WPI-AIM/AutoBVM/README.md

# AutoBVM
WPI AutoBVM Ventilator Project 
Developed as part of the Pandemic Engineering Program 

Designs for the system developed are avaialble here (mechanical, electrical, and software), and additional ongiong contributions and updates will appear here. All designs are available open source. We request that users inform us that are using them by emailing: info@autobvm.org. Please also contact us if you would like to contribute, which we highly encourage.

Please check in frequently as we are continuously making updates and will be curating feedback from others contributors here....

Please see http://autobvm.org for project information for the origins of this effort.
