WPI-AIM/AutoBVM/Electronics/README.md

The electronics hardware designs are in here.

Please see "Main Board Rev 2" for the latest and released board designs. This is what was provided to the goups that received pre-made hardware.

The posted designs include a pdf as a quick reference, manufacturing files to replicate, and Altium Designer files for viewing/modifying.
If you do not have Altium Designer, there is a free viewer avaialble online: https://www.altium.com/viewer/
