WPI-AIM/AutoBVM/Documentation/Docs - Breathing Circuit.pdf

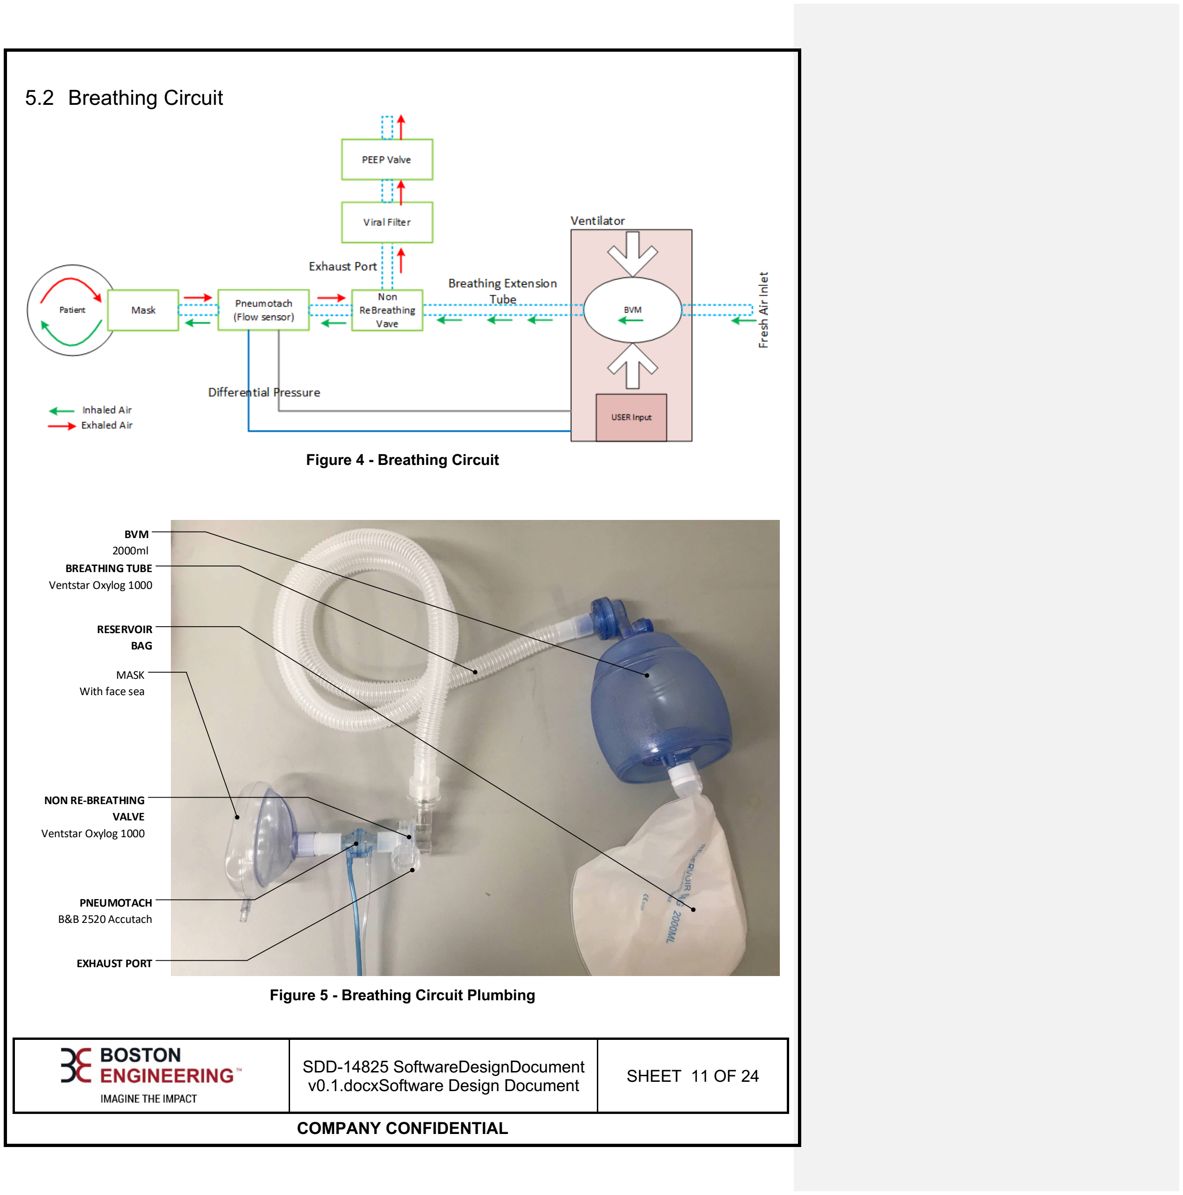
[picture p3: figure]
SDD-14825 SoftwareDesignDocument; COMPANY CONFIDENTIAL; 5.2 Breathing Circuit; Figure 4 - Breathing Circuit; Figure 5 - Breathing Circuit Plumbing; MASK With face sea; PNEUMOTACH B&B 2520 Accutach; EXHAUST PORT; NON RE-BREATHING VALVE Ventstar Oxylog 1000; BREATHING TUBE Ventstar Oxylog 1000; BVM 2000ml; RESERVOIR BAG

### v0.1.docxSoftware Design Document SHEET 11 OF 24
