WPI-AIM/AutoBVM/Electronics/LCD Board Rev 1/4391G01_BOM_6-2-21.xls

Comment | Description | Designator | Quantity | Manufacturer Part Number | Manufacturer | Supplier | Supplier Part Number
9774100151 | RND STNDFF M2.5X0.45 STEEL 10MM | MH3, MH4 | 2 | 9774100151R | Wurth Electronics | Digi-Key | 732-7117-1-ND
686106148922 | CONN 1MM HORZ BOTTOM SMD 6POS | J3 | 1 | 686106148922 | Wurth Electronics | Digi-Key | 732-6017-1-ND
N2526-6V0C-RB-WE | CONN HEADER SMD 26POS 2.54MM | J1 | 1 | N2526-6V0C-RB-WE | 3M | Digi-Key | MSH26KCT-ND
SSM-115-S-SV | CONN RCPT 15POS 0.1 GOLD SMD | J2 | 1 | SSM-115-S-SV | Samtec | Samtec | https://www.samtec.com/products/ssm-115-s-sv
