WPI-AIM/AutoBVM/Electronics/Main Board Rev 2/4381G01_Rev_2_BOM_7-7-21.xls

Comment | Description | Designator | Quantity | Manufacturer Part Number | Manufacturer | Supplier | Supplier Part Number | Rev 1 Qty | Difference
N2526-6002-RB | CONN HEADER VERT 26POS 2.54MM | J9 | 1 | N2526-6002RB | 3M | Digi-Key | MHC26K-ND | 1 | 0
CEP-2242 | Audio Indicators & Alerts Buzzers | BUZ1 | 1 | CEP-2242 | CUI | Digi-Key | 102-1115-ND | 1 | 0
GF-123-0054 | SWITCH SLIDE SPST 8.5A 125V | P13 | 1 | GF-123-0054 | CW Industries | Digi-Key | CWI333-ND | 1 | 0
78B05ST | SWITCH SLIDE DIP SPST 150MA 30V | SW1 | 1 | 78B05ST | Grayhill | Digi-Key | GH7186-ND | 1 | 0
M20-9980346 | CONN HEADER VERT 6POS 2.54MM | JP1, JP2, JP3, JP4, JP5, JP6 | 6 | M20-9980346 | Harwin | Digi-Key | 952-2121-ND | 6 | 0
SSCDRRN002NDAA5 | SENSOR PRES 0.07PSI DIFF 5V DIP | U6 | 1 | SSCDRRN002NDAA5 | Honeywell | Mouser | 785-SSCDRRN002NDAA5 | 0 | 1 | *BEC to Provide (Part Changed from SSCDRRN001PDAA5)
SSCDRRN001PGAA5 | SENSOR PRES 1PSI GAUG 5V DIP | U8, U9 | 2 | SSCDRRN001PGAA5 | Honeywell Sensing & Control | Digi-Key | 480-5972-ND | 2 | 0 | *BEC Already Provided and U9 DNP
BSC190N12NS3GATMA1 | MOSFET N-CH 120V 8.6A/44A TDSON | Q2 | 1 | BSC190N12NS3G | Infineon | Digi-Key | BSC190N12NS3GATMA1CT-ND | 1 | 0
3587TR | FUSE HOLDER BLADE 20A PCB | P9, P12 | 2 | 3587TR | Keystone Electronics | Digi-Key | 36-3587CT-ND | 2 | 0
5002 | PC TEST POINT MINIATURE WHITE | TP1, TP2, TP3, TP4, TP20, TP21, TP22, TP23, TP24, TP25, TP26, TP27, TP28, TP29, TP30, TP31, TP32, TP33, TP34, TP35, TP36, TP37, TP38 | 23 | 5002 | Keystone Electronics | Digi-Key | 36-5002-ND | 17 | 6
5001 | PC TEST POINT MINIATURE BLACK | TP10, TP11, TP12, TP13, TP17, TP19 | 6 | 5001 | Keystone Electronics | Digi-Key | 36-5001-ND | 6 | 0
5000 | PC TEST POINT MINIATURE RED | TP5, TP6, TP7, TP8, TP9, TP14, TP15, TP16, TP18 | 9 | 5000 | Keystone Electronics | Digi-Key | 36-5000-ND | 9 | 0
LTC4357IMS8 | IC OR CTRLR N+1 8MSOP | U2 | 1 | LTC4357IMS8 | Linear Technology | Digi-Key | LTC4357IMS8#PBF-ND | 1 | 0
SMAJ70CA | TVS DIODE 70VWM 113VC SMA | D1 | 1 | SMAJ70CA | Littlefuse Inc | Digi-Key | SMAJ70CALFCT-ND | 1 | 0
MAX14890EATJ+T | IC RECEIVER 0/4 32TQFN | U10 | 1 | MAX14890EATJ+T | Maxim | Digi-Key | MAX14890EATJ+TCT-ND | 1 | 0
24AA256T-I/SN | IC EEPROM 256KBIT I2C 8SOIC | U1 | 1 | 24AA256T-I/SN | Microchip | Mouser | 579-24AA256-I/SN | 1 | 0
43045-0828 | CONN HEADER VERT 8POS 3MM | P6 | 1 | 430450828 | Molex | Digi-Key | WM10693-ND | 1 | 0
BLM18RK102SN1D | FERRITE BEAD 1 KOHM 0603 1LN | FER1, FER2, FER3 | 3 | BLM18RK102SN1D | Murata | Digi-Key | 490-5228-1-ND | 2 | 1
NUD3124DMT1G | IC PWR DRIVER N-CHANNEL 1:1 SC74 | Q1, Q3 | 2 | NUD3124DMT1G | ON Semiconductor | Digi-Key | NUD3124DMT1GOSCT-ND | 2 | 0
MMBD1205 | DIODE ARRAY GP 100V 200MA SOT23 | D2 | 1 |  | On Semiconductor | Digi-Key | MMBD1205CT-ND | 1 | 0
1881639 | TERM BLOCK HDR 10POS VERT 2.5MM | P8, P10, P15 | 3 | 1881639 | Phoenix Contact | Digi-Key | 277-1460-ND | 3 | 0
1803442 | TERM BLOCK HDR 4POS VERT 3.81MM | P5, P16, P17, P18, P19 | 5 | 1803442 | Phoenix Contact | Digi-Key | 277-1223-ND | 5 | 0
1803439 | TERM BLOCK HDR 3POS VERT 3.81MM | P1, P2, P3, P4 | 4 | 1803439 | Phoenix Contact | Digi-Key | 277-1222-ND | 4 | 0
1755765 | TERM BLOCK HDR 5POS VERT 5.08MM | P14 | 1 | 1755765 | Phoenix Contact | Digi-Key | 277-1153-ND | 1 | 0
1755736 | TERM BLOCK HDR 2POS VERT 5.08MM | P7, P11, P20 | 3 | 1755736 | Phoenix Contact | Digi-Key | 277-1150-ND | 3 | 0
RP30-2412SEW | Single, Isolated Module DC DC Converter Output 12V - - 2.5A 10V - 40V Input | U3 | 1 | RP30-2412SEW | Recom | Digi-Key | 945-2750-5-ND | 1 | 0
1000pF | CAP CER 1000PF 2KV X7R 1206 | C6, C12 | 2 | CL31B102KJHNNNE | Samsung | Digi-Key | 1276-3073-1-ND | 2 | 0
PC81710NIP1B |  | OP1 | 1 | PC81710NIP1B | Sharp | Mouser | 852-PC81710NIP1B | 1 | 0
LD39150DT33-R | IC REG LINEAR 3.3V 1.5A DPAK | U5 | 1 | LD39150DT33-R | STMicroelectronics | Digi-Key | 497-6448-1-ND | 1 | 0
PPTC101LFBN-RC | CONN HDR 10POS 0.1 TIN PCB | J2 | 1 | PPTC101LFBN-RC | Sullins | Digi-Key | S7008-ND | 1 | 0
PPTC081LFBN-RC | CONN HDR 8POS 0.1 TIN PCB | J1, J3, J4, J5, J7 | 5 | PPTC081LFBN-RC | Sullins | Digi-Key | S7006-ND | 5 | 0
PPTC061LFBN-RC | CONN HDR 6POS 0.1 TIN PCB | J10, J11 | 2 | PPTC061LFBN-RC | Sullins | Digi-Key | S7004-ND | 2 | 0
PPPC182LFBN-RC | CONN HDR 36POS 0.1 GOLD PCB | J8 | 1 | PPPC182LFBN-RC | Sullins | Digi-Key | S7121-ND | 1 | 0
PPPC032LFBN-RC | CONN HDR 6POS 0.1 GOLD PCB | J6 | 1 | PPPC032LFBN-RC | Sullins | Digi-Key | S7106-ND | 1 | 0
196K | RES SMD 196K OHM 0.1% 1/8W 0805 | R80, R84, R88 | 3 | RG2012P-1963-B-T5 | Susumu | Digi-Key | RG20P196KBCT-ND | 3 | 0
100k | RES SMD 100K OHM 0.1% 1/8W 0805 | R77, R81, R85 | 3 | RG2012P-104-B-T5 | Susumu | Digi-Key | RG20P100KBCT-ND | 3 | 0
TSSA3U45 R3G | DIODE SCHOTTKY 45V 3A DO214AC | D3 | 1 | TSSA3U45 R3G | Taiwan Semiconductor | Digi-Key | TSSA3U45R3GCT-ND | 1 | 0
TS2596CM550RN | IC REG BUCK 5V 3A TO263-5 | U4 | 1 | TS2596CM550RN | Taiwan Semiconductor | Digi-Key | TS2596CM550RNGCT-ND | 1 | 0
1.0uF | CAP CER 1UF 50V X5R 0603 | C18, C20 | 2 | UMK107BJ105KA-T | Taiyo Yuden | Digi-Key | 587-2400-1-ND | 2 | 0
10uF | CAP CER 10UF 100V X7S 2220 | C17, C33 | 2 | C5750X7S2A106K230KB | TDK | Digi-Key | 445-13408-1-ND | 1 | 1
VCF4-1000 | RELAY SOCKET 5 POS THROUGH HOLE | K1, K2 | 2 | VCF4-1000 | TE Connectivity | Newark | 17M3156 | 2 | 0
SN74LVC1G125DBVT | IC BUF NON-INVERT 5.5V SOT23-5 | U12, U13 | 2 | SN74LVC1G125DBVT | Texas Instruments | Digi-Key | 296-26595-1-ND | 0 | 2 | *New Part on Rev 2
OPA4343UA | IC OPAMP GP 4 CIRCUIT 14SOIC | U7 | 1 | OPA4343UA | Texas Instruments | Digi-Key | 296-41593-5-ND | 1 | 0
CDCLVC1103PW | IC CLK BUFFER 1:3 250MHZ 8TSSOP | U11 | 1 | CDCLVC1103PW | Texas Instruments | Digi-Key | 296-33169-5-ND | 0 | 1 | *New Part on Rev 2
6.8µF | CAP CER 6.8UF 100V X7R 2220 | C8, C9 | 2 | KTS101B685K55F0T00 | United Chemi-Con | Digi-Key | 565-3678-1-ND | 2 | 0
470µF | CAP ALUM 470UF 20% 25V RADIAL | C7, C13, C15 | 3 | 860020474014 | Wurth Electronics | Digi-Key | 732-8831-1-ND | 3 | 0
450µH @ 100 kHz | CMC 450UH 6.5A 2LN TH | L1 | 1 | 7448227005 | Wurth Electronics | Digi-Key | 732-3883-ND | 1 | 0
47µH | FIXED IND 47UH 3.8A 60 MOHM SMD | L2, L3 | 2 | 7447709470 | Wurth Electronics | Newark | 08P2777 | 1 | 1
0 | RES SMD 0 OHM JUMPER 1/10W 0603 | R7, R8, R10, R14, R16, R17, R18, R19, R20, R21, R23, R25, R27, R29, R34, R38, R44, R47, R48, R49, R50, R51, R52, R53, R54, R56, R58, R59, R63, R64, R69, R71, R73, R74, R79, R83, R87, R89, R90, R92, R93, R98, R100, R101, R102, R103, R105, R106, R107, R109, R111, R113, R115, R117, R131, R132, R133, R134, R135, R136, R137, R138, R139, R140, R153, R154, R155, R156, R157, R158, R159, R160, R162, R163 | 74 | RC0603JR-070RL | Yageo | Digi-Key | 311-0.0GRCT-ND | 74 | 0
422 | RES SMD 422 OHM 1% 1/10W 0603 | R55 | 1 | RC0603FR-07422RL | Yageo | Digi-Key | 311-422HRCT-ND | 1 | 0
10 | RES SMD 10 OHM 1% 1/10W 0603 | R1, R2, R3, R4, R12, R13, R15, R22, R70, R78, R82, R86, R91 | 13 | RC0603FR-0710RL | Yageo | Digi-Key | 311-10.0HRCT-ND | 9 | 4
10k | RES SMD 10K OHM 1% 1/10W 0603 | R5, R6, R11, R26, R28, R30, R31, R32, R41, R42, R43, R46, R66, R67, R72, R75, R76, R94, R95, R96, R97, R120, R124, R125, R128, R144, R145, R146, R147, R148, R164 | 31 | RC0603FR-0710KL | Yageo | Digi-Key | 311-10.0KHRCT-ND | 24 | 7
0.1µF | Cap Ceramic 0.1uF 100V X7R 10% Pad SMD 0603 125°C T/R | C1, C2, C3, C4, C5, C14, C16, C21, C22, C23, C24, C25, C26, C27, C28, C29, C30, C31, C34, C35 | 20 | CC0603KRX7R0BB104 | Yageo | Digi-Key | 311-1523-1-ND | 17 | 3
2.2µF | CAP CER 2.2UF 25V X5R 0603 | C10, C11, C19, C32 | 4 | CC0603KRX5R8BB225 | Yageo | Digi-Key | 311-1786-1-ND | 3 | 1
R0603_DNP | R0603 Do Not Populate | R9, R24, R33, R35, R36, R37, R39, R40, R45, R57, R60, R61, R62, R65, R68, R99, R104, R108, R110, R112, R114, R116, R118, R119, R121, R122, R123, R126, R127, R129, R130, R141, R142, R143, R149, R150, R151, R152, R161, R165 | 40 | N/A | N/A | N/A | N/A | 46 | -6
