WPI-AIM/AutoBVM/Documentation/calibration transforms/test_setup.pdf

# Fluke Test Setup

# June 8th, 2021

## Relationship between Flow and Diff. Pressure Flow range: 0 to 180Liters/min Resolution: 40ml/min

## 25250 (https://bandb-medical.com/wp-content/uploads/2020/05/25250C2-Accutach.pdf)

VT650 (https://www.flukebiomedical.com/products/biomedical-test-equipment/gas-flow-analyzers-ventilator-testers/vt650-gas-flow-analyzer-ventilator-tester)

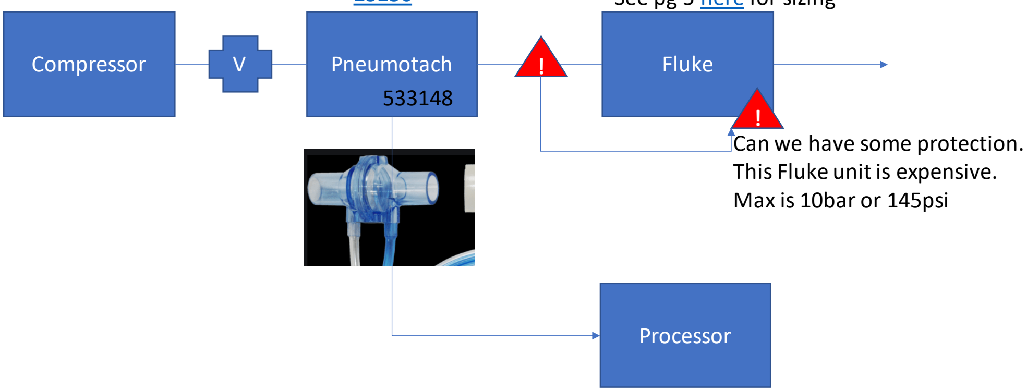
[picture p5: figure]
Compressor; Pneumotach; Fluke; Processor; ! Can we have some protection. This Fluke unit is expensive. Max is 10bar or 145psi

See pg 5 here (https://www.flukebiomedical.com/sites/default/files/6009788c-en-vt650-ds.pdf) for sizing

## Initial Proposed Set-Up

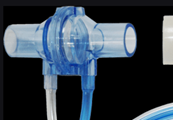
[picture p6: figure]
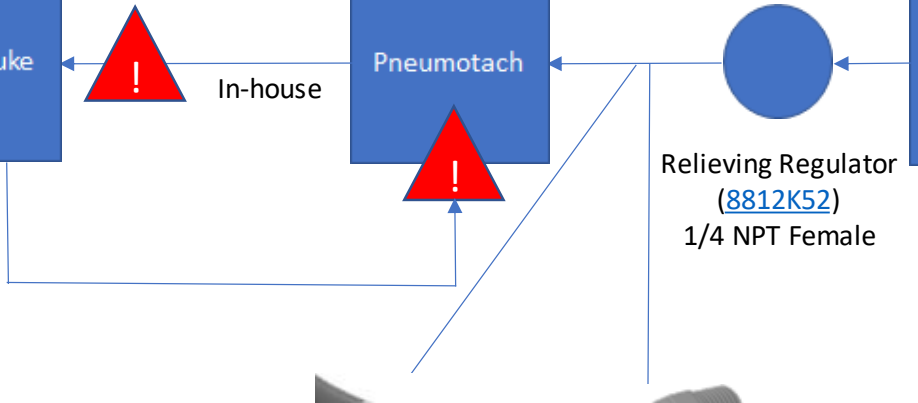
[picture p7: figure]
Relieving Regulator (8812K52) 1/4 NPT Female; In-house

Adapter
(5372K747) (https://www.mcmaster.com/5372K747/)
1/4 NPT to 10 mm

Tygon PVC Tubing
(3902N306) (https://www.mcmaster.com/3902N306/)
10 mm ID, 17 mm OD

Flow: 0 to 180 L/min (~ 6 cfm) Accuracy: +/- 25 mL or +/- 10% Connectors: 22 mm OD tubing

25250 (https://bandb-medical.com/wp-content/uploads/2020/05/25250C2-Accutach.pdf) Pneumotach Flow Sensor

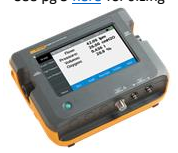
[picture p8: figure]

Flow: 0 to 300 SLPM
Accuracy: 1.7% or 0.04 SLPM Connectors: 15mm ID/ 22mm OD adapter

VT650 (https://www.flukebiomedical.com/products/biomedical-test-equipment/gas-flow-analyzers-ventilator-testers/vt650-gas-flow-analyzer-ventilator-tester) Gas Flow Analyzer
See pg 5 here (https://www.flukebiomedical.com/sites/default/files/6009788c-en-vt650-ds.pdf) for sizing

Tygon PVC Tubing
(3902N306) (https://www.mcmaster.com/3902N306/)
10 mm ID, 17 mm OD

Pressure Release Valve
(5 psi, 4772K2) (https://www.mcmaster.com/4772K2-4772K201/)
1/8 NPT Male

Adapter
(5372K747) (https://www.mcmaster.com/5372K747/)
1/4 NPT to 10 mm

Relationship between Flow and Diff. Pressure
Operating Parameters: 1 psi max, up to 180 L/min (~6 cfm)

Note: Tygon tubing to be attached to Fluke outlet and Pneumotach inlet via moisture-seal heat shrink (74965K57) (https://www.mcmaster.com/74965K57/)

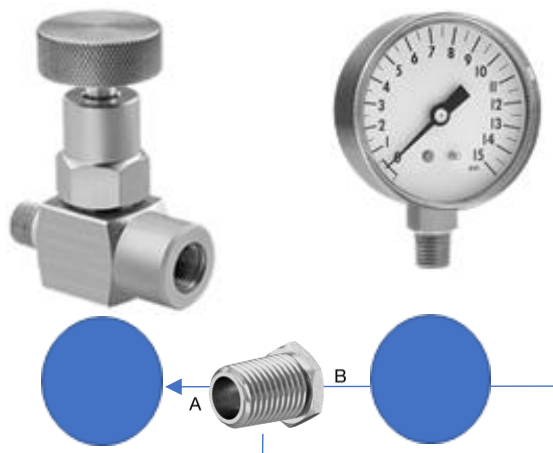
[picture p9: figure]

Gauge
(3846K411) (https://www.mcmaster.com/3846K411-3846K412/)
1/8 NPT Pipe Size
OD: 2.0625”

Needle Valve
(7833K76) (https://www.mcmaster.com/7833K76/)
1/4 NPT Thread

Al Manifold
(5975K31) (https://www.mcmaster.com/5975K31/)

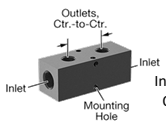
[picture p10: figure]

Inlets: 1/4 NPT Threaded
Outlets: 1/8 NPT Male

## Final Proposed Set-Up

Reducer
(4464K261) (https://www.mcmaster.com/4464K261/)
1/4 to 1/8 NPT

## Variable Definition: ρ: density of air

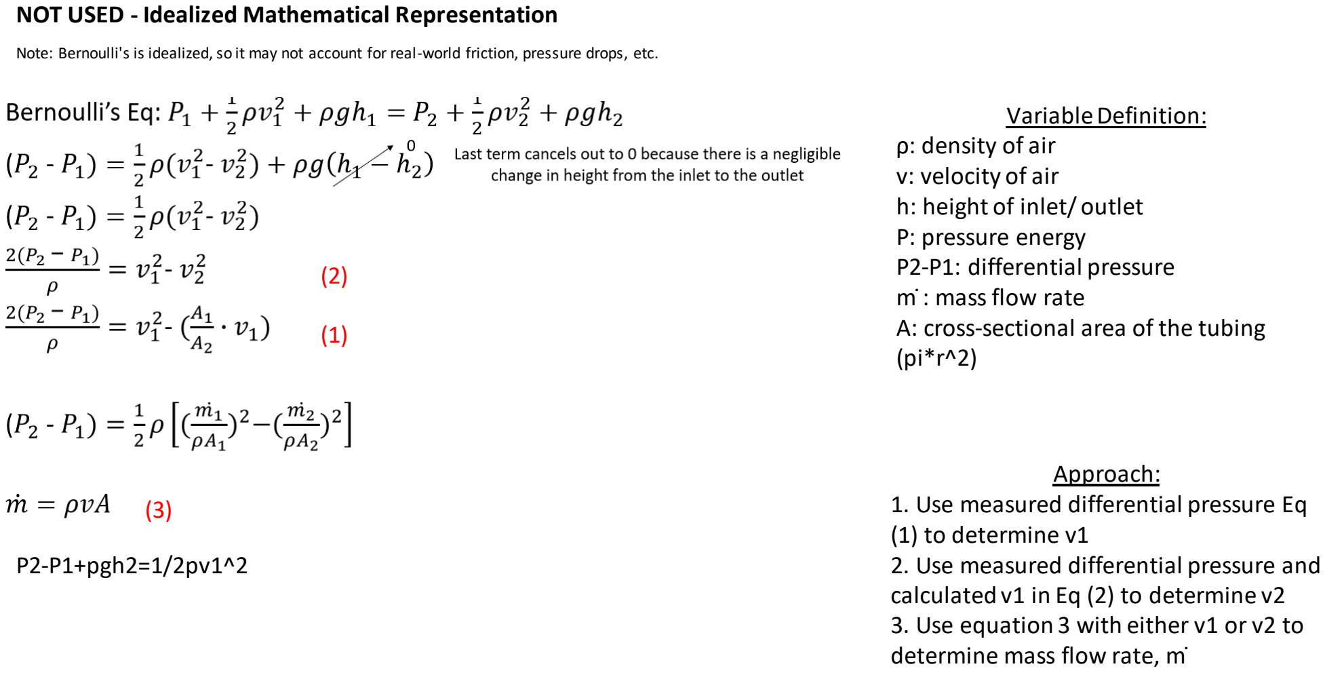
[picture p11: page 4]

## Approach: 1. Use measured differential pressure Eq (1) to determine v1 2. Use measured differential pressure and calculated v1 in Eq (2) to determine v2 3. Use equation 3 with either v1 or v2 to determine mass flow rate, m ̇

## v: velocity of air h: height of inlet/ outlet P: pressure energy P2-P1: differential pressure m ̇: mass flow rate A: cross-sectional area of the tubing (pi*r^2)

## NOT USED - Idealized Mathematical Representation

Note: Bernoulli's is idealized, so it may not account for real-world friction, pressure drops, etc.

(1)

(2)

(3)

## P2-P1+pgh2=1/2pv1^2
