WPI-AIM/AutoBVM/Documentation/calibration transforms/deg vs volume.xlsx

 |  |  |  |  |  |  |  |  | PADDLE POSITION(deg) vs BAG VOLUME(l)
Test Setup
 | Ambu bag model: AMBU SPUR II
 | Ventilator->Ambu Bag->Pneumotach(Unused, but in loop)->Fluke->Lung
 | Bag exhaust port closed.
 | Run following steps for No Lung, C=50, C=20
Step 1 | Take 5 sets of readings @20 deg/sec and 100 deg/sec of the paddle
Step 2 | Average the readings
Step 3 | Curve fit the average
Step 4 | Curve fit for inverse Volume vs Degree
 |  |  |  |  |  |  |  |  |  |  |  |  |  |  |  | Speed (20 deg/sec) |  |  |  |  |  |  | Speed (100 deg/sec) |  |  |  |  |  |  | Speed (20 deg/sec) |  |  |  |  |  |  | Speed (100 deg/sec)
 | Speed (20 deg/sec) |  |  |  |  |  |  |  | Speed (100 deg/sec) |  |  |  |  |  |  | With Lung, C = 50 (mL/cmH20) |  |  |  |  |  |  | With Lung, C = 50 (mL/cmH20) |  |  |  |  |  |  | With Lung, C = 20 (mL/cmH20) |  |  |  |  |  |  | With Lung, C = 20 (mL/cmH20)
 | No Lung |  |  |  |  |  |  |  | No Lung |  |  |  |  |  |  |  | test 1 | test 2 | test 3 | test 4 | test 5 | Average |  | test 1 | test 2 | test 3 | test 4 | test 5 | Average |  | test 1 | test 2 | test 3 | test 4 | test 5 | Average |  | test 1 | test 2 | test 3 | test 4 | test 5 | Average
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
