WPI-AIM/AutoBVM/Documentation/calibration transforms/diff_to_flow.xlsx

Sheet: 0.04 mbar steps
 |  |  |  |  |  |  | DIFFERENTIAL PRESSURE(mbar)vs FLOW(lpm)
Test Setup
Inspiration | Compressor->Regulator->Pneumotach(Low pressure ports of Fluke)->Fluke->Needle Valve
Expiration | Compressor->Regulator->Fluke->Pneumotach(Low pressure ports of Fluke)->Needle Valve
 | Change Diff Pressure(mbar) in increments of 0.04 and note Flow(lpm)
Step 1 | Take 3 sets of readings
Step 2 | Average the readings
Step 3 | Curve fit the readings
 | Repeat for Expiration
 |  | STEP 1 - Take 3 sets of readings |  |  |  | STEP 2 - Average the readings |  |  |  |  |  |  |  |  |  |  |  |  | STEP 3 - Curve fit the readings
Inflow(INSPIRATION) |  |  |  |  |  |  |  |  |  |  |  |  | Average observation
Test 1 (inflow, 0.04 mbar steps) |  | Test 2 (inflow, 0.04 mbar steps) |  | Test 3(inflow, 0.04 mbar steps) |  | Average Inflow
DP (mbar) | Flow (lpm) | DP (mbar) | Flow (lpm) | DP (mbar) | Flow (lpm) | DP (mbar) | Flow (lpm) | Average Difference | Average % Difference | DP (mbar) x | Flow (lpm) y | y from curve fit | Difference | % Difference | Average Difference | Average % Difference | Result of 4 mbar step Tests
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
