WPI-AIM/AutoBVM/Electronics/LCD Board Rev 1/PCB - Display Interface.pdf

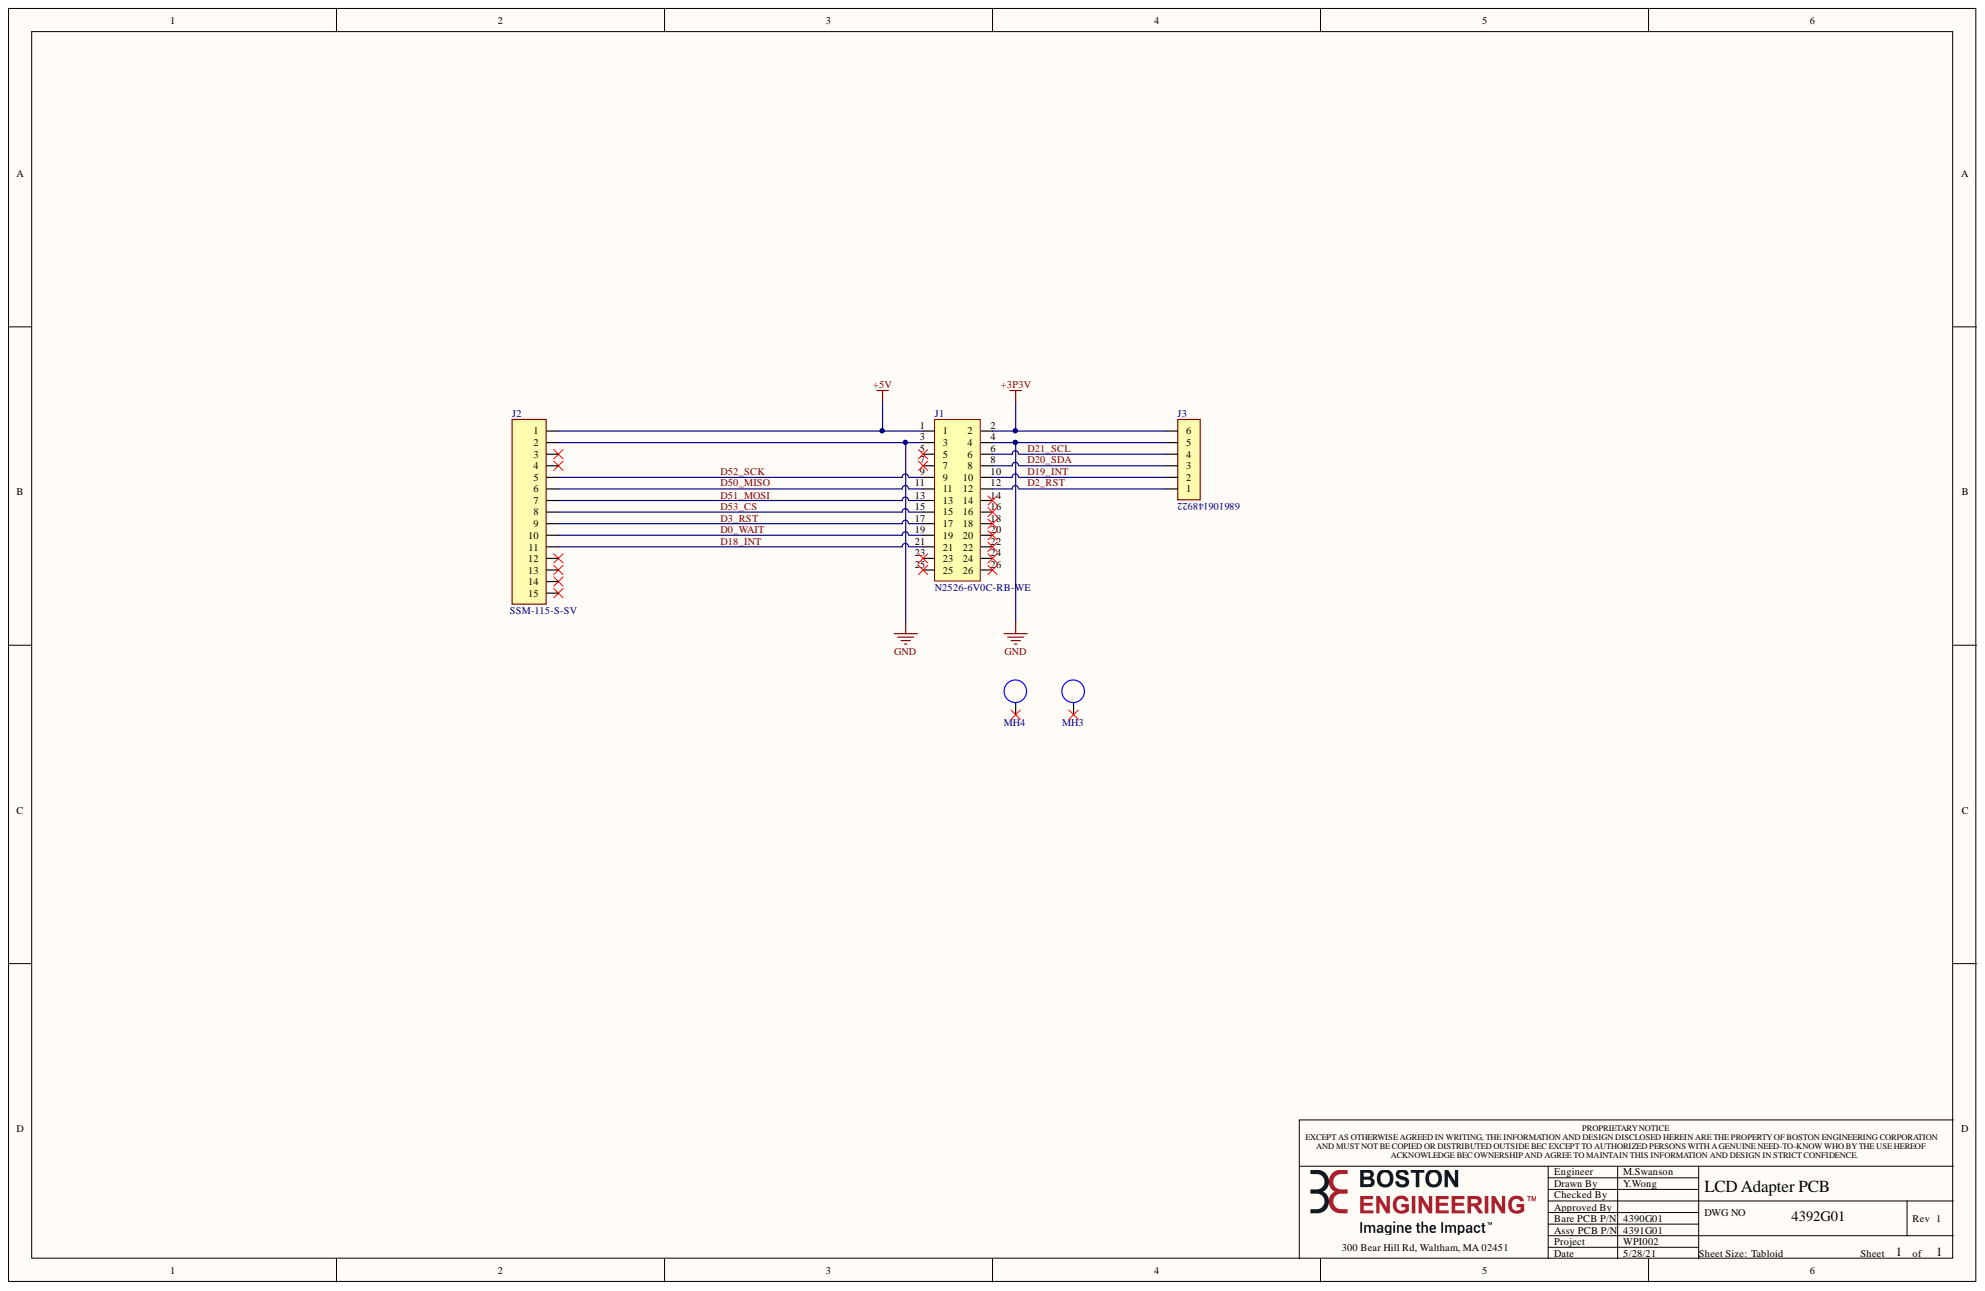
[picture p12: page 1]

3 0 0 B e a r H i l l R d , Wa l t h a m , MA 0 2 4 5 1 | E n g i n e e r | M. S w a n s o n | LCD Adapte r P C B

D r a w n B y | Y. Wo n g
C h e c k e d B y
A p p r o v e d B y | | DWG N O 4392G01 | R e v 1
B a r e P C B P / N | 4 3 9 0 G 0 1
A s s y P C B P / N | 4 3 9 1 G 0 1
P r oj e c t | WP I 0 0 2 | 1 1 S h e e t S i z e : Ta b l o i d S h e e t o f
D a t e | 5 / 2 8 / 2 1

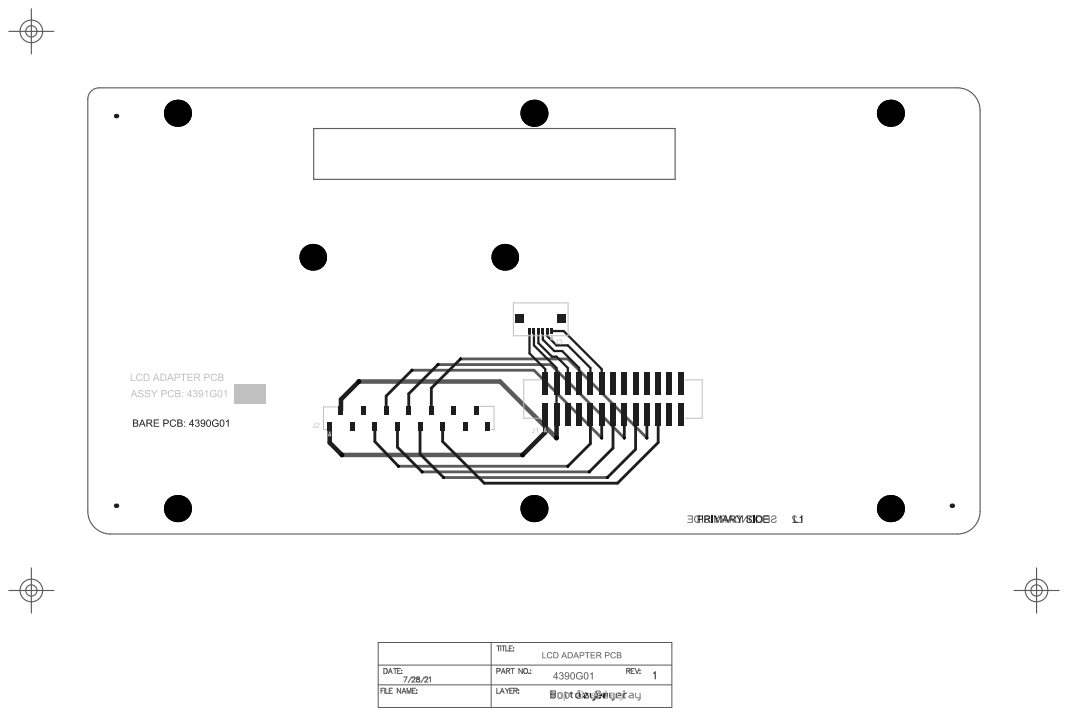
[picture p13: page 2]

Comment | Description | Designator | Footprint | LibRef | Quantity
N2526-6V0C-RB-WE | CONN HEADER SMD 2J1 | | 3M\N2526-6V0C-RB-WN2526-6V0C-RB-WE | | 1
SSM-115-S-SV | CONN RCPT 15POS 0.J2 | | SSM-115-S-SV | SSM-115-S-SV | 1
686106148922 | CONN 1MM HORZ BOTJ3 | | 686106148922 | 686106148922 | 1
9774100151 | RND STNDFF M2.5X0.MH3, MH 4 | | 9774100151 | 9774100151 | 2
