WPI-AIM/AutoBVM/Updated Firmware/source/src/controls/control.cpp

#include "control.h"
#include <display/main_display.h>
#include <utilities/util.h>
#include "../config/uvent_conf.h"
#include "actuators/actuator.h"
#include "eeprom/storage.h"
#include "sensors/pressure_sensor.h"
#include "waveform.h"
#include "alarm/alarm.h"
#include <AccelStepper.h>
#include <DueTimer.h>
#include <ams_as5048b.h>
#include <display/screens/screen.h>
#include <display/layouts/layouts.h>

#include "pcvmachine.h"
#include "pressurePID.h"

// PID Controller Instance
// PressurePID pid;

// Instance to control the paddle

// const double Kp = 0.0011;       // VALUES OBTAINED FROM A RESEARCH PAPER
// const double Ki = 0.012;
// const double Kd = 0.000015;

// const double Kp = 1.0;       // TEST VALUES
// const double Ki = 0.0;
// const double Kd = 0.0;

// float prevError = 0;
// float prevIntegral = 0;
// float bias = 0;

// // Used for timing purposes
// bool firstPID = true;
// float timeSincePID = 0;

// float target = 15.0;

// bool startPID = false;

Actuator actuator;

// Storage instance
Storage storage;

// Gauge Pressure Sensor instance
PressureSensor gauge_sensor = {PRESSURE_GAUGE_PIN};

// Differential Pressure Sensor instance
PressureSensor diff_sensor = {PRESSURE_DIFF_PIN};
// Waveform instance
Waveform waveform;

uint32_t cycle_count = 0;

// Alarms
AlarmManager alarm_manager{SPEAKER_PIN, &cycle_count};

/* State machine instance. Takes in a pointer to actuator
 * as there are actuator commands within the state machine.
 */
Machine machine(States::ST_STARTUP, &actuator, &waveform, &gauge_sensor, &alarm_manager, &cycle_count);
PCVMachine pcvMachine(States::ST_STARTUP, &actuator, &waveform, &gauge_sensor, &alarm_manager, &cycle_count);


// Bool to keep track of the alert box
static bool alert_box_already_visible = false;

void loop_test_readout(lv_timer_t* timer)
{

    static bool timer_delay_complete = false;

    // Internal timers, components might have different refresh times
    static uint32_t last_readout_refresh = 0;

    // Don't poll the sensors before we're sure everything's had a chance to init
    if (!timer_delay_complete && (millis() >= SENSOR_POLL_STARTUP_DELAY)) {
        timer_delay_complete = true;

        // Set some dummy alarms
        cycle_count++;

        alarm_manager.badPlateau(true);
        alarm_manager.lowPressure(true);
        alarm_manager.noTidalPres(true);
        alarm_manager.update();
    }
    if (!timer_delay_complete) {
        LV_LOG_TRACE("Timer is not ready yet, returning (%d)", millis());
        return;
    }

    // If verbose data polling is off, polling / updates won't be done if the state machine is off
    // If in debug screen mode, it won't be done if we're in startup state either
#if VERBOSE_DATA_POLLING == 0
    States cur_state = control_get_state();
    if (cur_state == States::ST_OFF || (!ENABLE_CONTROL && cur_state == States::ST_STARTUP)) {
        return;
    }
#endif

    // Main screen, passed through via user data in main.cpp
    auto* screen = static_cast<MainScreen*>(timer->user_data);

    // Check for errors
    handle_alerts();

    // Poll gauge sensor, add point to graph and update readout obj.
    // Will not refresh until explicitly told
    static double cur_pressure = -2;
    screen->get_chart(CHART_IDX_PRESSURE)->add_data_point(cur_pressure);           // JOSH PRESSURE
    set_readout(AdjValueType::CUR_PRESSURE, cur_pressure);
    screen->get_chart(CHART_IDX_FLOW)->add_data_point(cur_pressure);
    set_readout(AdjValueType::PLAT_PRESSURE, cur_pressure);
    cur_pressure += 1;
    cur_pressure += random(100) / 100.0;
    if (cur_pressure > 40) {
        cur_pressure -= 42;
    }

    // Poll vT sensor, add point to graph and update readout obj.
    // Will not refresh until explicitly told
    static int16_t test2 = 0;
    double cur_tidal_volume = test2;
    set_readout(AdjValueType::TIDAL_VOLUME, cur_tidal_volume);
    test2 += 50;
    if (test2 > 1000) {
        test2 -= 1002;
    }

    set_readout(RESPIRATION_RATE, 30);

    set_readout(PEEP, 30);
    set_readout(PIP, 30);

    // Check to see if it's time to refresh the readout boxes
    if (has_time_elapsed(&last_readout_refresh, READOUT_REFRESH_INTERVAL)) {
        // Refresh all of the readout labels
        for (auto& value : adjustable_values) {
            if (!value.is_dirty()) {
                continue;
            }
            value.refresh_readout();
            value.clear_dirty();
        }
    }

    screen->try_refresh_charts();
}

void loop_update_readouts(lv_timer_t* timer)
{
    static bool timer_delay_complete = false;

    // Internal timers, components might have different refresh times
    static uint32_t last_readout_refresh = 0;

    // Don't poll the sensors before we're sure everything's had a chance to init
    if (!timer_delay_complete && (millis() >= SENSOR_POLL_STARTUP_DELAY)) {
        timer_delay_complete = true;
    }
    if (!timer_delay_complete) {
        LV_LOG_TRACE("Timer is not ready yet, returning (%d)", millis());
        return;
    }

    // If verbose data polling is off, polling / updates won't be done if the state machine is off
    // If in debug screen mode, it won't be done if we're in startup state either
#if VERBOSE_DATA_POLLING == 0
    States cur_state = control_get_state();
    if (cur_state == States::ST_OFF || (!ENABLE_CONTROL && cur_state == States::ST_STARTUP)) {
        return;
    }
#endif

    // Main screen, passed through via user data in main.cpp
    auto* screen = static_cast<MainScreen*>(timer->user_data);

    // Check for errors
    handle_alerts();

    // Poll gauge sensor, add point to graph and update readout obj.
    // Will not refresh until explicitly told

    // JOSH PRESSURE could take this value, compare it to a target, then call a function to adjust adjustable values to reduce/increase pressure
    double cur_pressure = control_get_gauge_pressure();

    // will probably have to change how timing works, first calculation may be uneccesarily massive, could limit speed too and leave timing maybe

    if(pcvMachine.get_last_state() == States::ST_OFF && pcvMachine.get_current_state() == States::ST_INSPR)
    {
        pcvMachine.startPID = true;
    }
    
    // if(pcvMachine.startPID == true)
    // {
        if(pcvMachine.firstPID == true)
        {
            float error = pcvMachine.target - cur_pressure;
            float integral = pcvMachine.prevIntegral + error;           // MOVE OUT OF HERE AND INTO PCVMACHINE.CPP ONCE VALUES MAKE SENSE
            float derivative = (error - pcvMachine.prevError);
             
            // double output = Kp*error + Ki*integral + Kd*derivative + bias;
            double output = pcvMachine.Kp*error + pcvMachine.Ki*integral + pcvMachine.Kd*derivative + pcvMachine.bias;

            pcvMachine.prevError = error;
            pcvMachine.prevIntegral = integral;

            screen->get_chart(CHART_IDX_PRESSURE)->add_data_point(output);      // STOPPING THE SCREEN FROM TURNING ON
            set_readout(AdjValueType::CUR_PRESSURE, output);

            pcvMachine.firstPID = false;
            pcvMachine.timeSincePID = millis();
        }

        else
        {
            float error = pcvMachine.target - cur_pressure;
            float integral = pcvMachine.prevIntegral + (error * (millis() - pcvMachine.timeSincePID));           // ERROR WILL KEEP GETTING MORE MASSIVE UNLESS PRESSURE GOES OVER TARGET
            float derivative = (error - pcvMachine.prevError) / (millis() - pcvMachine.timeSincePID);
            
            float output = pcvMachine.Kp*error + pcvMachine.Ki*integral + pcvMachine.Kd*derivative + pcvMachine.bias;

            pcvMachine.prevError = error;
            pcvMachine.prevIntegral = integral;

            screen->get_chart(CHART_IDX_PRESSURE)->add_data_point(output);
            set_readout(AdjValueType::CUR_PRESSURE, output);

            pcvMachine.timeSincePID = millis();
        }  
    // } 

    if(machine.get_current_state() == States::ST_OFF)
    {
        pcvMachine.startPID = false;
    }


    // screen->get_chart(CHART_IDX_PRESSURE)->add_data_point(cur_pressure);                // IMPORTANT JOSH PRESSURE, UNCOMMENT IF WANT PRESSURE PRINTED
    // set_readout(AdjValueType::CUR_PRESSURE, cur_pressure);

    // Poll sensors, update readout obj.
    // Will not refresh until explicitly told
    // Waveform parameters
    waveform_params* p_wave_params = control_get_waveform_params();
    set_readout(AdjValueType::TIDAL_VOLUME, p_wave_params->m_tidal_volume);   // JOSH PRESSURE
    set_readout(AdjValueType::RESPIRATION_RATE, p_wave_params->m_rr);
    set_readout(AdjValueType::IE_RATIO_LEFT, p_wave_params->m_ie_i);
    set_readout(AdjValueType::IE_RATIO_RIGHT, p_wave_params->m_ie_e);
    set_readout(AdjValueType::PEEP, p_wave_params->m_peep);
    set_readout(AdjValueType::PIP, p_wave_params->m_pip);
    set_readout(AdjValueType::PLAT_PRESSURE, p_wave_params->m_plateau_press);

    double cur_flow = diff_sensor.get_flow(units_flow::lpm, true, Order_type::third);
    screen->get_chart(CHART_IDX_FLOW)->add_data_point(cur_flow);
    set_readout(AdjValueType::FLOW, cur_flow);

    // TODO add more sensors HERE

    // Check to see if it's time to refresh the readout boxes
    if (has_time_elapsed(&last_readout_refresh, READOUT_REFRESH_INTERVAL)) {
        // Refresh all of the readout labels
        for (auto& value : adjustable_values) {
            if (!value.is_dirty()) {
                continue;
            }
            value.refresh_readout();
            value.clear_dirty();
        }
    }

    screen->try_refresh_charts();
}

void handle_alerts()
{
    static uint16_t last_alarm_count = 0;
    uint16_t alarm_count = control_get_alarm_count();
    if (alarm_count <= 0 && alert_box_already_visible) {
        alert_box_already_visible = false;
        last_alarm_count = 0;
        set_alert_count_visual(0);
        set_alert_text("");
        set_alert_box_visible(false);
        return;
    }

    if (alarm_count > 0 && !alert_box_already_visible) {
        alert_box_already_visible = true;
        set_alert_box_visible(true);
    }

    if (last_alarm_count != alarm_count) {
        last_alarm_count = alarm_count;

        Alarm* alarm_arr = control_get_alarm_list();
        String alarm_strings[NUM_ALARMS];
        uint16_t buf_size = 0;
        uint16_t alarm_list_idx = 0;
        for (uint16_t i = 0; i < NUM_ALARMS; i++) {
            Alarm* a = &alarm_arr[i];
            if (!a->isON()) {
                continue;
            }
            buf_size += a->text().length();
            alarm_strings[alarm_list_idx++] = a->text();
        }

        set_alert_count_visual(alarm_count);
        set_alert_text(alarm_strings, alarm_count, buf_size);
    }
}

void control_update_waveform_param(AdjValueType type, float new_value)  // Buttons to adjust setting values?    JOSH PRESSURE
{
    if (type >= AdjValueType::ADJ_VALUE_COUNT) {
        return;
    }
    waveform_params* wave_params = control_get_waveform_params();
    switch (type) {
        case TIDAL_VOLUME:
            wave_params->volume_ml = new_value;
            LV_LOG_INFO("Tidal Volume is now %.1f", new_value);
            break;
        case RESPIRATION_RATE:
            wave_params->bpm = (uint16_t) new_value;
            LV_LOG_INFO("Respiration Rate is now %.1f", new_value);
            break;
        case PIP:
            wave_params->pip = (uint16_t) new_value;
            LV_LOG_INFO("PIP is now %.1f", new_value);
            break;
        case PEEP:
            wave_params->peep = (uint16_t) new_value;
            LV_LOG_INFO("PEEP is now %.1f", new_value);
            break;
        case PLATEAU_TIME:
            wave_params->plateau_time = (uint16_t) new_value;
            LV_LOG_INFO("PLATEAU TIME is now %.1f", new_value);
            break;
        case IE_RATIO_LEFT:
            wave_params->ie_i = new_value;
            LV_LOG_INFO("IE Inspiration is now %.1f", new_value);
            break;
        case IE_RATIO_RIGHT:
            wave_params->ie_e = new_value;
            LV_LOG_INFO("IE Expiration is now %.1f", new_value);
            break;
        default:
            break;
    }
}

/**
 * Loads a target value from EEPROM at startup and sets it to its interface class.
 * This function will recalculate the waveform itself, no other action is needed.
 * @param value The value we're loading.
 * @param settings Pre-Loaded settings object to retrieve from.
 */
static void load_stored_target(AdjustableValue* value, uvent_settings& settings)
{
    double val = 0;
    switch (value->value_type) {
        case TIDAL_VOLUME:
            val = settings.tidal_volume;
            break;
        case RESPIRATION_RATE:
            val = settings.respiration_rate;
            break;
        case PEEP:
            val = settings.peep_limit;
            break;
        case PIP:
            val = settings.pip_limit;
            break;
        case PLATEAU_TIME:
            val = settings.plateau_time;
            break;
        case IE_RATIO_LEFT:
            val = settings.ie_ratio_left;
            break;
        case IE_RATIO_RIGHT:
            val = settings.ie_ratio_right;
            break;
        default:
            break;
    }
    value->set_value_target(val);
    control_update_waveform_param(value->value_type, (float) val);
}

void init_adjustable_values()       // JOSH PRESSURE
{
    uvent_settings settings{};
    storage.get_settings(settings);

    for (uint8_t i = 0; i < AdjValueType::ADJ_VALUE_COUNT; i++) {
        AdjustableValue* value_class = &adjustable_values[i];
        value_class->init(static_cast<AdjValueType>(i));
        load_stored_target(value_class, settings);
        value_class->set_value_measured(READOUT_VALUE_DEFAULT);
    }
    adjustable_values[AdjValueType::IE_RATIO_LEFT].set_selected(false);
}

double get_control_target(AdjValueType type)
{
    if (type >= AdjValueType::ADJ_VALUE_COUNT) {

        return adjustable_values[type].get_settings().default_value;
    }

    return *adjustable_values[type].get_value_target();
}

void set_readout(AdjValueType type, double val)
{
    if (type >= AdjValueType::ADJ_VALUE_COUNT) {
        return;
    }
    adjustable_values[type].set_value_measured(val);
}

double get_readout(AdjValueType type)
{
    if (type >= AdjValueType::ADJ_VALUE_COUNT) {
        return -1;
    }
    return *adjustable_values[type].get_value_measured();
}

void control_handler()
{
    static bool ledOn = false;

    // LED to visually show state machine is running.
    digitalWrite(DEBUG_LED, ledOn);

    // Toggle the LED.
    ledOn = !ledOn;

    // Run the state machine
    machine.run();
}

/* Interrupt callback to service the actuator
 * The actuator, in this case a stepper is serviced periodically
 * to "step" the motor.
 */
void actuator_handler()
{
    actuator.run();
}

/* Initilaize sub-systems
 */
void control_init()                                         // JOSH PRESSURE
{
#if ENABLE_CONTROL
    // Debug led setup
    pinMode(DEBUG_LED, OUTPUT);

    //  Storage init
    storage.init();

    // Check EEPROM CRC. Load defaults if CRC fails.
    if (!storage.is_crc_ok()) {
        Serial.println("CRC failed. Loading defaults.");
        // No settings found, or settings corrupted.
        storage.load_defaults();
    }

    // Initialize the actuator, NEED TO CALL THIS AGAIN IF MOTOR IS SWITCHED
    actuator.init();

    /* On startup, the angle feedback sensor needs to be programmed with a calibrated
     * zero. Usually this is an OTP value burned into the angle register, but it is risky to
     * do that, as the magnet may fall or go out-of alignment during transport and the zero cannot
     * be programmed again(because OTP).
     * To avoid the risk, the EEPROM stores the zero value, which is burned in during manufacture.
     * This value can be changed by manually "re-homing" the actuator at the user's discretion.
     *
     * The below few lines, load the zero value from the EEPROM into the angle sensor register
     * at statup. Control can then use the value from the angle sensor to home the actuator.
     */
    uvent_settings settings;
    storage.get_settings(settings);
    actuator.set_zero_position(settings.actuator_home_offset_adc_counts);

    // Initialize the Gauge Pressure Sensor
    gauge_sensor.init(MAX_GAUGE_PRESSURE, MIN_GAUGE_PRESSURE, RESISTANCE_1, RESISTANCE_2, 0);

    // Initialize the Differential Pressure Sensor
    if (settings.diff_pressure_type == PRESSURE_SENSOR_TYPE_0) {
        diff_sensor.init(MAX_DIFF_PRESSURE_TYPE_0, MIN_DIFF_PRESSURE_TYPE_0, RESISTANCE_1, RESISTANCE_2, 0);
    }
    else if (settings.diff_pressure_type == PRESSURE_SENSOR_TYPE_1) {
        diff_sensor.init(MAX_DIFF_PRESSURE_TYPE_1, MIN_DIFF_PRESSURE_TYPE_1, RESISTANCE_1, RESISTANCE_2, 0);
    }

    // Initialize the state machine

    if(pcv == false) {
        machine.setup();
    }
    if(pcv == true) {
        pcvMachine.setup();
    }

    /* Setup a timer and a function handler to run
     * the state machine.
     */
    Timer0.attachInterrupt(control_handler);
    Timer0.start(CONTROL_HANDLER_PERIOD_US);

    /* Setup a timer and a function handler to run
     * the actuation.
     */
    Timer1.attachInterrupt(actuator_handler);
    Timer1.start(ACTUATOR_HANDLER_PERIOD_US);

#endif
}

/* Called by loop() from main, this function services control
 * parametes and functions.
 * Since this is called by the loop(), the call interval
 * in not periodic.
 */
void control_service()
{
}

/* Get the current angular position of the actuator
 */
double control_get_actuator_position()
{
    return actuator.get_position();
}

/* Get the current raw register value of the angle sensor.
 * This is a debug stub used to get the offset to set home.
 */
int8_t control_get_actuator_position_raw(double& angle)
{
    return actuator.get_position_raw(angle);
}

/**
 * DO NOT USE UNLESS ABSOLUTELY NECESSARY
 */
void control_eeprom_write_default()
{
    storage.load_defaults();
}

/* Set the current angular position of the actuator as home
 */
void control_zero_actuator_position()
{
    uvent_settings settings;
    storage.get_settings(settings);

    // Zero the angle sensor and write the value to the EEPROM
    settings.actuator_home_offset_adc_counts = actuator.set_current_position_as_zero();

    // Store this value to the eeprom.
    storage.set_settings(settings);
}

void control_write_ventilator_params()
{
    uvent_settings settings;
    storage.get_settings(settings);

    settings.tidal_volume = (uint16_t) get_control_target(TIDAL_VOLUME);
    settings.respiration_rate = (uint8_t) get_control_target(RESPIRATION_RATE);
    settings.peep_limit = (uint8_t) get_control_target(PEEP);
    settings.pip_limit = (uint8_t) get_control_target(PIP);
    settings.plateau_time = (uint16_t) get_control_target(PLATEAU_TIME);
    settings.ie_ratio_left = get_control_target(IE_RATIO_LEFT);
    settings.ie_ratio_right = get_control_target(IE_RATIO_RIGHT);

    storage.set_settings(settings);
}

void control_get_serial(char* serial_buffer)
{
    uvent_settings settings{};
    storage.get_settings(settings);

    memcpy(serial_buffer, settings.serial, 12);
}

/* Request to switch the state of the state machine.
 */
void control_change_state(States new_state)
{
    machine.change_state(new_state);
}

// void control_change_motor(Motors new_motor)  // Change motors to be utilized in machine.cpp
// {
   
        
//         if(machine.get_current_state() == States::ST_OFF)
//         {
//             machine.change_motor(new_motor);
//             control_init();            
//         }
        
    
    
// }

void control_change_mode(ControlModes new_mode)  // Change motors to be utilized in machine.cpp
{
   
        
        if(machine.get_current_state() == States::ST_OFF)  // DON'T NECESSARILY NEED THIS CHECK, BUT HAVING IT ENSURES NOTHING CAN GO WRONG, COULD MAYBE MAKE THE MOTOR HOME ITSELF THEN SWITCH IF STILL ON
        {
            // machine.change_mode(new_mode);
            // NEED SOME KIND OF CONTROL_CHANGE_MODE() THAT CHANGES WHICH MACHINE OBJECT IS CREATED BEFORE IT'S INTIALIZED
            control_init();            
        }
        
    
    
}

void control_actuator_manual_move(Tick_Type tt, double angle, double speed)
{
    actuator.set_position_relative(tt, angle);
    actuator.set_speed(tt, speed);
}

States control_get_state()
{
    return machine.get_current_state();
}

const char* control_get_state_string()
{
    return machine.get_current_state_string();
}

const char** control_get_state_list(uint8_t* size)
{
    return machine.get_state_list(size);
}

void control_display_storage()
{
    storage.display_storage();
}

bool control_is_crc_ok()
{
    return storage.is_crc_ok();
}

double control_get_degrees_to_volume(C_Stat compliance)
{
    return actuator.degrees_to_volume(compliance);
}

double control_get_degrees_to_volume_ml(C_Stat compliance)
{
    return actuator.degrees_to_volume(compliance) * 1000;
}

double control_calc_volume_to_degrees(C_Stat compliance, double volume)
{
    return actuator.volume_to_degrees(compliance, volume);
}

void control_actuator_set_enable(bool en)
{
    actuator.set_enable(en);
}

waveform_params* control_get_waveform_params(void)
{
    return (waveform.get_params());
}

void control_calculate_waveform()
{
    waveform.calculate_waveform();
}

void control_waveform_display_details()
{
    waveform.display_details();
}

double control_get_gauge_pressure()
{
    // if(pcv == false){                                                // JOSH PRESSURE
        return gauge_sensor.get_pressure(units_pressure::cmH20);
    // }
    // if(pcv == true){
    //     // pull adjustable value
    // }
}

double control_get_diff_pressure()
{
    return diff_sensor.get_pressure(units_pressure::cmH20);
}

void control_setup_alarm_cb()
{
    alarm_manager.set_snooze_cb([]() {
        lv_obj_t* mute_button = get_mute_button();
        if (!mute_button) {
            return;
        }

        lv_obj_clear_state(mute_button, LV_STATE_CHECKED);
    });
}

void control_alarm_snooze()
{
    alarm_manager.snooze();
}

void control_set_fault(Fault id)
{
    machine.set_fault(id);
}

void control_toggle_alarm_snooze()
{
    alarm_manager.toggle_snooze();
}

int16_t control_get_alarm_count()
{
    return alarm_manager.numON();
}

String control_get_alarm_text()
{
    return (alarm_manager.getText());
}

void control_set_alarm_all_off()
{
    alarm_manager.allOff();
}

Alarm* control_get_alarm_list()
{
    return alarm_manager.getAlarmList();
}

void control_alarm_test()
{
    alarm_manager.overCurrent(true);
}
