WPI-AIM/AutoBVM/Updated Firmware/source/src/actuators/actuator.h

#ifndef UVENT_ACTUATOR_H
#define UVENT_ACTUATOR_H

#include "stepper.h"
#include "wiper.h"
#include "controls/fault.h"

/* The type of ticks for the motor.
 * Although the actuator can be controlled in degrees,
 * having access to the steps allows for easier debuggin
 * This enum aids in transforming values from the higher
 * layers to steps, which the low level uses.
 */
enum class Tick_Type {
    TT_DEGREES,
    TT_STEPS
};

/* The type of equation used is based on whether values from 
 * the Fluke Biomedical VT900A Gas Flow Analyzer were taken
 * with or without a artificial lung. Values taken
 * with a artificial lung were taken at
 * Static compliance levels of C = 50, C = 20, and C = none (no lung)
*/
enum class C_Stat {
    NONE,
    FIFTY,
    TWENTY
};

enum class Motors {  // Class containing all motors that can be switched to (can add more motors if needed in the future)
    STEPPER = 0,
    WIPER
};

enum class ControlModes {
    VCV = 0,
    PCV
};

class Actuator
/* There can be other actuator types - steppers, DC motors,
 * Wiper DC motors. The actuator interface serves as a common interface
 * to any of them. To use other drives or motors, an associated driver
 * needs to be written. 
 * Here, the stepper driver is used.
 */
{
public:
    void init();
    void run();
    void set_enable(bool);

    // void change_motor(Motors motor); // Switch between motors

    // Set the speed in steps.
    void set_speed(Tick_Type tt, float speed);

    float get_current_speed();
    void home();
    
    // Use for when actuator is in expiration state (machine is in state ST_EXPR)
    void home_expiration();

    // Functions checking when the wiper motor is moving or not.
    void set_wiper_motor_on();
    void set_wiper_motor_off();
    void set_cycle_end_on();
    void set_cycle_end_off();

    bool is_home();
    bool is_moving();
    double get_position();
    int8_t get_position_raw(double&);
    double degrees_to_volume(C_Stat compliance);
    uint16_t set_current_position_as_zero();
    void set_zero_position(uint16_t new_zero);
    void set_position(Tick_Type tt, double value);
    void set_position_relative(Tick_Type tt, double value);
    bool is_running();
    void set_position_as_home();
    bool target_reached();
    bool add_correction();
    double volume_to_degrees(C_Stat compliance, double volume);
    void calculate_trajectory(const float& duration_s, const float& pause_s, const float& goal_pos_deg, float& vel_deg);

    void wiper_set_interval(float interval);

private:
    Stepper stepper;  // Motor object declarations
    Wiper wiper;

    // int motorType = 1;  // 1 = stepper motor, 2 = wiper motor

    // Feedback
    AMS_AS5048B stepper_fb;

    // Prev. value of angle sensor.
    // Used to detect movement.
    double prev_position;

    // No Lung - Degrees To Volume(D2V)
    // y = -5E-09*x^4 + 1E-06x^3 - 4E-05x^2 + 0.0003x
    // C_Stat = none
    // Equation was derived by mapping volume displaced per degree the paddle moved. A Fluke Biomedical VT900A Gas Flow Analyzer was used to measure the volume displaced.
    double const D2V_COEF_A_NO_LUNG = -0.00000000539259422946378;
    double const D2V_COEF_B_NO_LUNG = 0.00000137006464979886;
    double const D2V_COEF_C_NO_LUNG = -0.0000370548541166471;
    double const D2V_COEF_D_NO_LUNG = 0.000260254960634754;

    // No Lung - Volume To Degrees(V2D)
    // y = 227.452^3 - 424.84x^2 + 309.29x + 26.668
    // C_Stat = none
    // Equation was derived by mapping volume displaced per degree the paddle moved. A Fluke Biomedical VT900A Gas Flow Analyzer was used to measure the volume displaced.
    double const V2D_COEF_A_NO_LUNG = 227.42;
    double const V2D_COEF_B_NO_LUNG = -424.84;
    double const V2D_COEF_C_NO_LUNG = 309.29;
    double const V2D_COEF_D_NO_LUNG = 26.668;

    // With Lung - Degrees To Volume(D2V)
    // y = -3E-09*x^4 + 9E-07*x^3 - 3E-05*x^2 - 7E-05*x
    // C_Stat = 20 (mL/cmH2O)
    // Equation was derived by mapping volume displaced per degree the paddle moved. A Fluke Biomedical VT900A Gas Flow Analyzer was used to measure the volume displaced.
    double const D2V_COEF_A_COMP_20 = -0.00000000318509207676739;
    double const D2V_COEF_B_COMP_20 = 0.000000868855116173189;
    double const D2V_COEF_C_COMP_20 = -0.0000278632433332315;
    double const D2V_COEF_D_COMP_20 = -0.0000703187442674391;

    // With Lung - Volume To Degrees(V2D)
    // y = 612.61^3 - 812.82x^2 + 436.56x + 34.416
    // C_Stat = 20 (mL/cmH2O)
    // Equation was derived by mapping volume displaced per degree the paddle moved. A Fluke Biomedical VT900A Gas Flow Analyzer was used to measure the volume displaced.
    double const V2D_COEF_A_COMP_20 = 612.61;
    double const V2D_COEF_B_COMP_20 = -812.82;
    double const V2D_COEF_C_COMP_20 = 436.56;
    double const V2D_COEF_D_COMP_20 = 34.416;

    // With Lung
    // y = -3E-09*x^4 + 8E-07*x^3 - 3E-06*x^2 - 0.0006*x
    // C_Stat = 50 (mL/cmH2O)
    // Equation was derived by mapping volume displaced per degree the paddle moved. A Fluke Biomedical VT900A Gas Flow Analyzer was used to measure the volume displaced.
    double const D2V_COEF_A_COMP_50 = -0.00000000342520216878951;
    double const D2V_COEF_B_COMP_50 = 0.000000834768084837607;
    double const D2V_COEF_C_COMP_50 = -0.00000305968137895296;
    double const D2V_COEF_D_COMP_50 = -0.000643516160449664;

    // With Lung - Volume To Degrees(V2D)
    // y = 263.07^3 - 449.69x^2 + 321.88x + 30.01
    // C_Stat = 50 (mL/cmH2O)
    // Equation was derived by mapping volume displaced per degree the paddle moved. A Fluke Biomedical VT900A Gas Flow Analyzer was used to measure the volume displaced.
    double const V2D_COEF_A_COMP_50 = 263.07;
    double const V2D_COEF_B_COMP_50 = -449.69;
    double const V2D_COEF_C_COMP_50 = 321.88;
    double const V2D_COEF_D_COMP_50 = 30.01;

    float degrees_to_steps(const float& d_val);
    float steps_to_degrees(const float& s_val);
};

#endif
