WPI-AIM/AutoBVM/Updated Firmware/source/src/utilities/be_tm_tagline_logo_png.c

#include <lvgl.h>

#ifndef LV_ATTRIBUTE_MEM_ALIGN
#define LV_ATTRIBUTE_MEM_ALIGN
#endif

#ifndef LV_ATTRIBUTE_IMG_BE_TM_TAGLINE_LOGO
#define LV_ATTRIBUTE_IMG_BE_TM_TAGLINE_LOGO
#endif

const LV_ATTRIBUTE_MEM_ALIGN LV_ATTRIBUTE_LARGE_CONST LV_ATTRIBUTE_IMG_BE_TM_TAGLINE_LOGO uint8_t be_tm_tagline_logo_map[] = {
  /*Pixel format:  Blue: 5 bit Green: 6 bit, Red: 5 bit, Alpha 8 bit  BUT the 2  color bytes are swapped*/
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
};

const lv_img_dsc_t be_tm_tagline_logo = {
  .header.always_zero = 0,
  .header.w = 90,
  .header.h = 106,
  .data_size = 9540 * LV_IMG_PX_SIZE_ALPHA_BYTE,
  .header.cf = LV_IMG_CF_TRUE_COLOR_ALPHA,
  .data = be_tm_tagline_logo_map,
};
