WPI-AIM/AutoBVM/Updated Firmware/source/src/utility/w5500.cpp

/*
 * Copyright (c) 2010 by WIZnet <support@wiznet.co.kr>
 *
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
 * - 10 Apr. 2015
 * Added support for Arduino Ethernet Shield 2
 * by Arduino.org team
 */




#include <stdio.h>
#include <string.h>
#include "Arduino.h"

#include "utility/w5500.h"
//#if defined(W5500_ETHERNET_SHIELD)

// W5500 controller instance
W5500Class w5500;


#if !defined(WIZ550ioWITH_MACADDRESS)

w5500.swReset();

#endif
// SPI details
SPISettings wiznet_SPI_settings(8000000, MSBFIRST, SPI_MODE0);
uint8_t SPI_CS;

void W5500Class::init(uint8_t ss_pin)
{
  SPI_CS = ss_pin;

  delay(1000);
  initSS();
  SPI.begin();
  w5500.swReset();
  for (int i=0; i<MAX_SOCK_NUM; i++) {
    uint8_t cntl_byte = (0x0C + (i<<5));
    write( 0x1E, cntl_byte, 2); //0x1E - Sn_RXBUF_SIZE
    write( 0x1F, cntl_byte, 2); //0x1F - Sn_TXBUF_SIZE
  }
}

uint16_t W5500Class::getTXFreeSize(SOCKET s)
{
    uint16_t val=0, val1=0;
    do {
        val1 = readSnTX_FSR(s);
        if (val1 != 0)
            val = readSnTX_FSR(s);
    } 
    while (val != val1);
    return val;
}

uint16_t W5500Class::getRXReceivedSize(SOCKET s)
{
    uint16_t val=0,val1=0;
    do {
        val1 = readSnRX_RSR(s);
        if (val1 != 0)
            val = readSnRX_RSR(s);
    } 
    while (val != val1);
    return val;
}

void W5500Class::send_data_processing(SOCKET s, const uint8_t *data, uint16_t len)
{
  // This is same as having no offset in a call to send_data_processing_offset
  send_data_processing_offset(s, 0, data, len);

}

void W5500Class::send_data_processing_offset(SOCKET s, uint16_t data_offset, const uint8_t *data, uint16_t len)
{
    uint16_t ptr = readSnTX_WR(s);
    uint8_t cntl_byte = (0x14+(s<<5));
    ptr += data_offset;
    write(ptr, cntl_byte, data, len);
    ptr += len;
    writeSnTX_WR(s, ptr);
}

void W5500Class::recv_data_processing(SOCKET s, uint8_t *data, uint16_t len, uint8_t peek)
{
    uint16_t ptr;
    ptr = readSnRX_RD(s);

    read_data(s, ptr, data, len);
    if (!peek)
    {
        ptr += len;
        writeSnRX_RD(s, ptr);
    }
}

void W5500Class::read_data(SOCKET s, volatile uint16_t src, volatile uint8_t *dst, uint16_t len)
{
    uint8_t cntl_byte = (0x18+(s<<5));
    read((uint16_t)src , cntl_byte, (uint8_t *)dst, len);
}

uint8_t W5500Class::write(uint16_t _addr, uint8_t _cb, uint8_t _data)
{
    SPI.beginTransaction(wiznet_SPI_settings);
    setSS();  
    SPI.transfer(_addr >> 8);
    SPI.transfer(_addr & 0xFF);
    SPI.transfer(_cb);
    SPI.transfer(_data);
    resetSS();
    SPI.endTransaction();

    return 1;
}

uint16_t W5500Class::write(uint16_t _addr, uint8_t _cb, const uint8_t *_buf, uint16_t _len)
{
    SPI.beginTransaction(wiznet_SPI_settings);
    setSS();
    SPI.transfer(_addr >> 8);
    SPI.transfer(_addr & 0xFF);
    SPI.transfer(_cb);
    for (uint16_t i=0; i<_len; i++){
        SPI.transfer(_buf[i]);
    }
    resetSS();
    SPI.endTransaction();

    return _len;
}

uint8_t W5500Class::read(uint16_t _addr, uint8_t _cb)
{
    SPI.beginTransaction(wiznet_SPI_settings);
    setSS();
    SPI.transfer(_addr >> 8);
    SPI.transfer(_addr & 0xFF);
    SPI.transfer(_cb);
    uint8_t _data = SPI.transfer(0);
    resetSS();
    SPI.endTransaction();

    return _data;
}

uint16_t W5500Class::read(uint16_t _addr, uint8_t _cb, uint8_t *_buf, uint16_t _len)
{ 
    SPI.beginTransaction(wiznet_SPI_settings);
    setSS();
    SPI.transfer(_addr >> 8);
    SPI.transfer(_addr & 0xFF);
    SPI.transfer(_cb);
    for (uint16_t i=0; i<_len; i++){
        _buf[i] = SPI.transfer(0);
    }
    resetSS();
    SPI.endTransaction();

    return _len;
}

void W5500Class::execCmdSn(SOCKET s, SockCMD _cmd) {
    // Send command to socket
    writeSnCR(s, _cmd);
    // Wait for command to complete
    while (readSnCR(s))
    ;
}


uint8_t W5500Class::readVersion(void)
{
    SPI.beginTransaction(wiznet_SPI_settings);
    setSS();
    SPI.transfer( 0x00 );
    SPI.transfer( 0x39 );
    SPI.transfer( 0x01);
    uint8_t _data = SPI.transfer(0);
    resetSS();
    SPI.endTransaction();

    return _data;
}


//#endif
