WPI-AIM/AutoBVM/Updated Firmware/source/src/utilities/waves.h

#ifndef UVENT_WAVES_H
#define UVENT_WAVES_H

#define WAVE_LEN 64

const char sin_wave_static[] = {
        0x80, 0x8c, 0x98, 0xa5, 0xb0, 0xbc, 0xc6, 0xd0, 0xda, 0xe2, 0xea, 0xf0, 0xf5, 0xfa, 0xfd, 0xfe, 0xff, 0xfe,
        0xfd, 0xfa, 0xf5, 0xf0, 0xea, 0xe2, 0xda, 0xd0, 0xc6, 0xbc, 0xb0, 0xa5, 0x98, 0x8c,
        0x80, 0x73, 0x67, 0x5a, 0x4f, 0x43, 0x39, 0x2f, 0x25, 0x1d, 0x15, 0xf, 0xa, 0x5, 0x2, 0x1, 0x0, 0x1, 0x2, 0x5,
        0xa, 0xf, 0x15, 0x1d, 0x25, 0x2f, 0x39, 0x43, 0x4f, 0x5a, 0x67, 0x73,
};

#endif //UVENT_WAVES_H
