WPI-AIM/AutoBVM/(commit log)

2022-05-23 Initial Posting
    Initial commit with software version from release at delivery.
    [4381G01_BOM_6-2-21.xls, 4381G01_Rev_2_BOM_7-7-21.xls, 4391G01_BOM_6-2-21.xls, deg vs volume.xlsx, diff_to_flow.xlsx]
2022-08-25 Version 1.0.1
    Fixed a bug where the pedal would switch direction mid-cycle if told to move back to the home position while in the expiration state.
    [actuator.cpp, actuator.h, machine.cpp, machine.h, stepper.cpp, stepper.h]
