WPI-AIM/AutoBVM/(notices)

Notices in the files:
Updated Firmware/source/src/utility/w5500.h:
This file is free software; you can redistribute it and/or modify
it under the terms of either the GNU General Public License version 2
or the GNU Lesser General Public License version 2.1, both as
published by the Free Software Foundation.
